Awasthiutk564/Campus-Drop/report-figures/fig-0-cover-hardware-photo.jpg

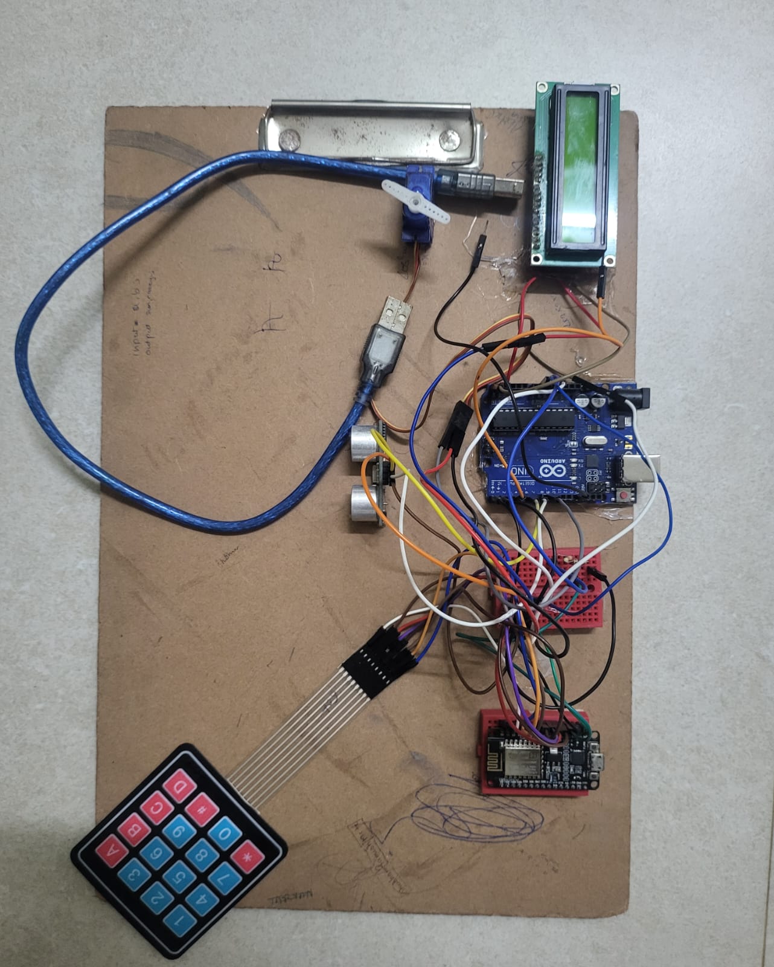
report-figures/fig-0-cover-hardware-photo.jpg
