Awasthiutk564/Campus-Drop/report-figures/fig-5-2-circuit-diagram.png

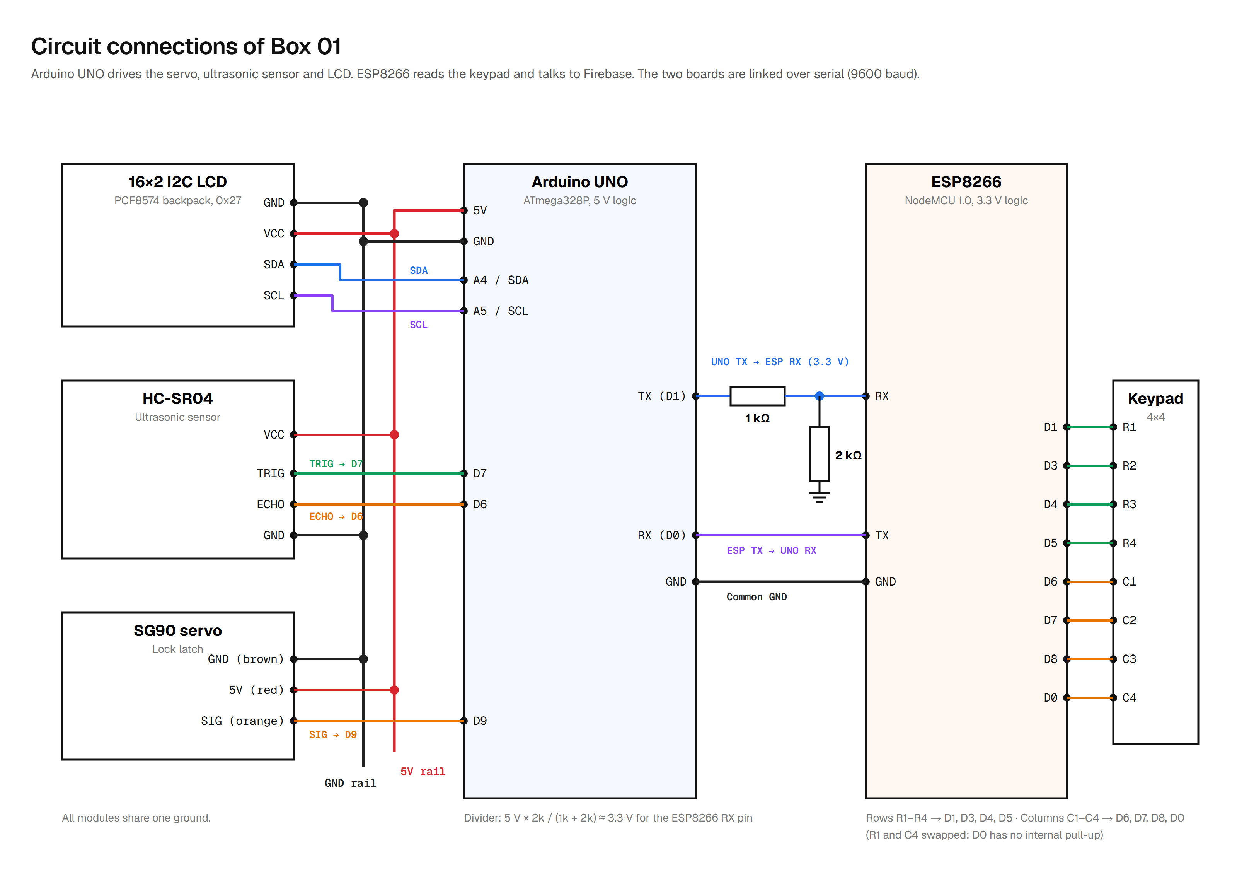
report-figures/fig-5-2-circuit-diagram.png
