Awasthiutk564/Campus-Drop/report-figures/fig-5-3-internal-arrangement.png

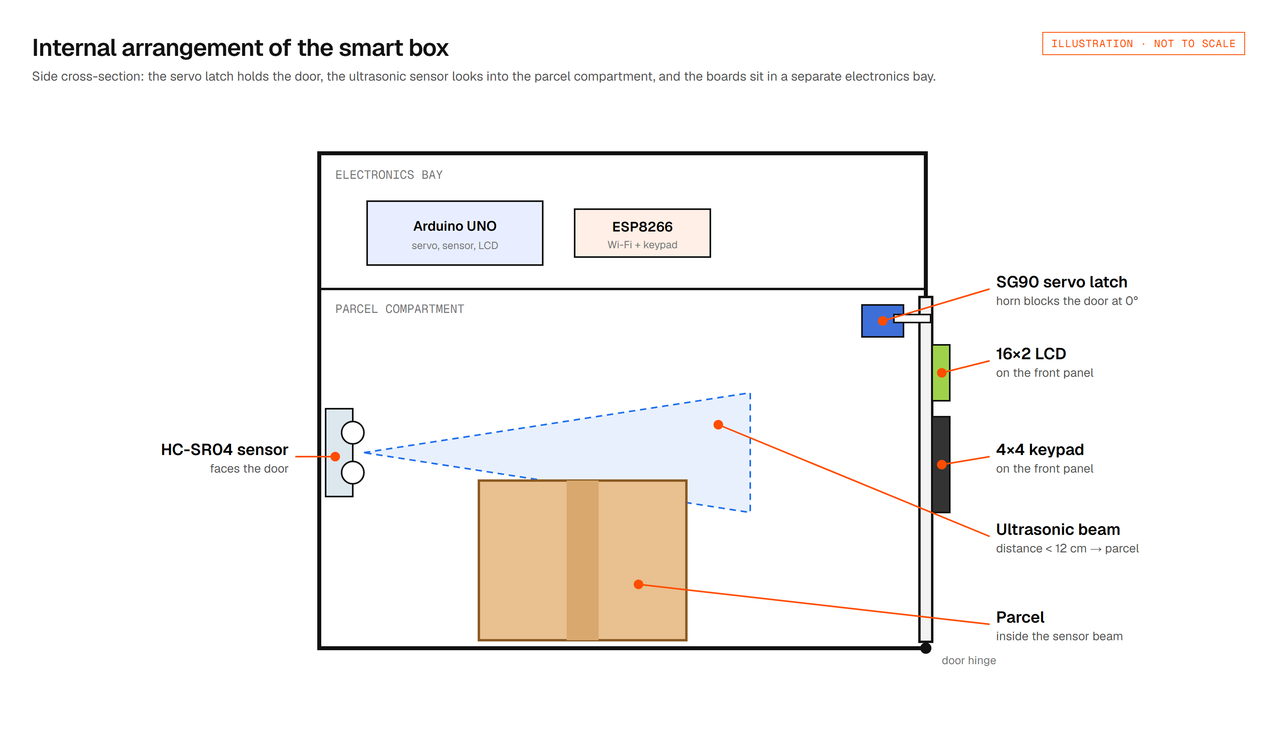
report-figures/fig-5-3-internal-arrangement.png
