Awasthiutk564/Campus-Drop/report-figures/fig-5-4-front-panel.png

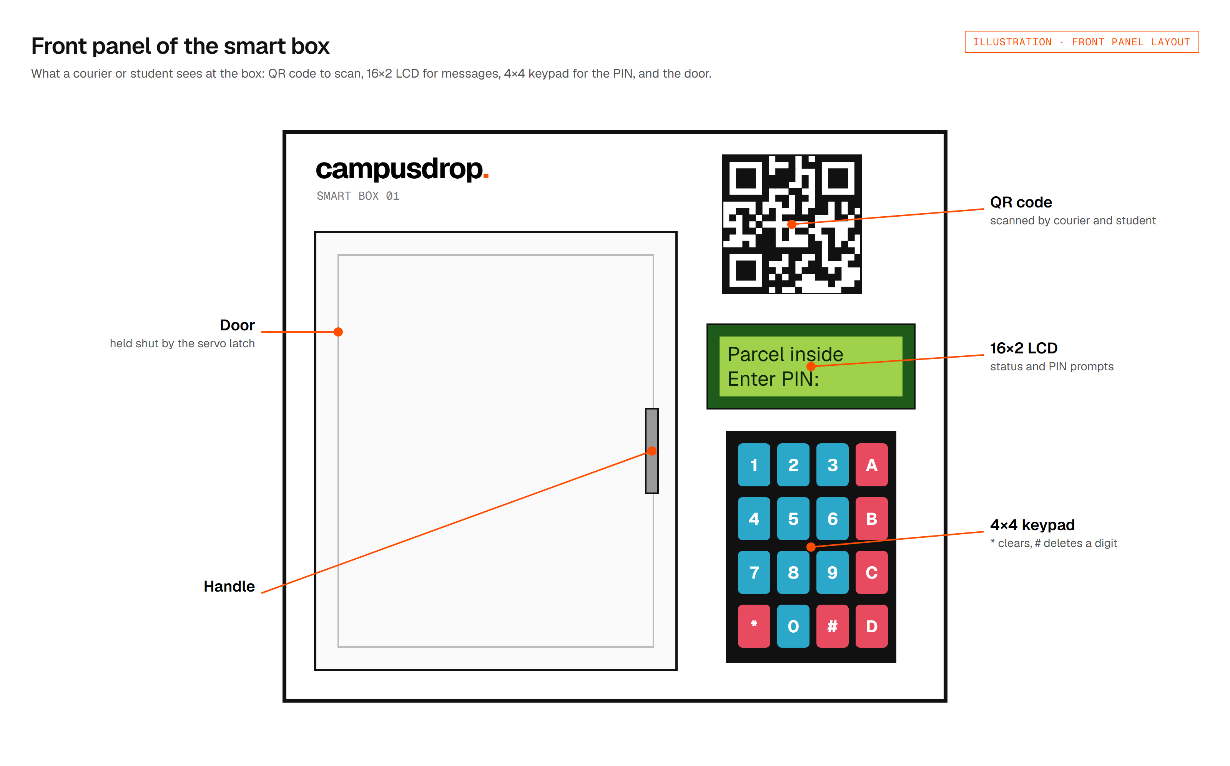
report-figures/fig-5-4-front-panel.png
