Awasthiutk564/Campus-Drop/report-figures/fig-6-0-dashboard-hero.png

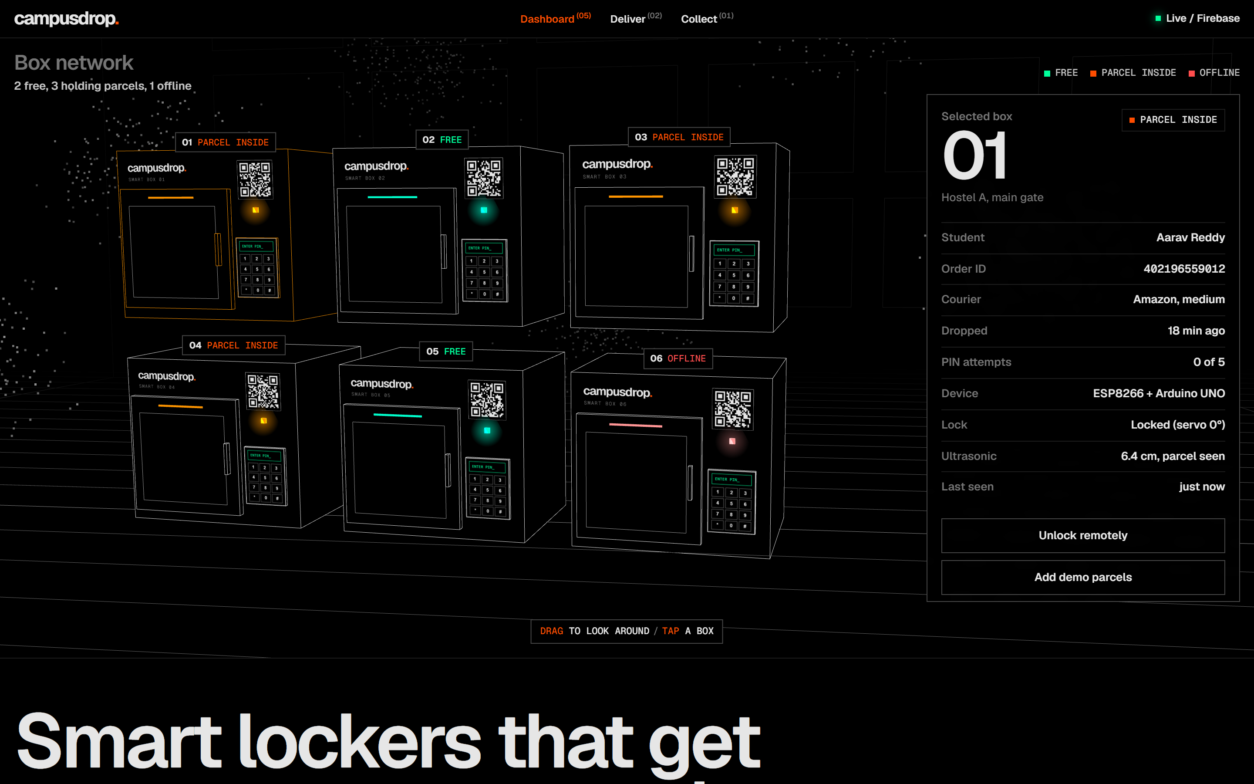
report-figures/fig-6-0-dashboard-hero.png
