Awasthiutk564/Campus-Drop/report-figures/fig-6-1-dashboard.png

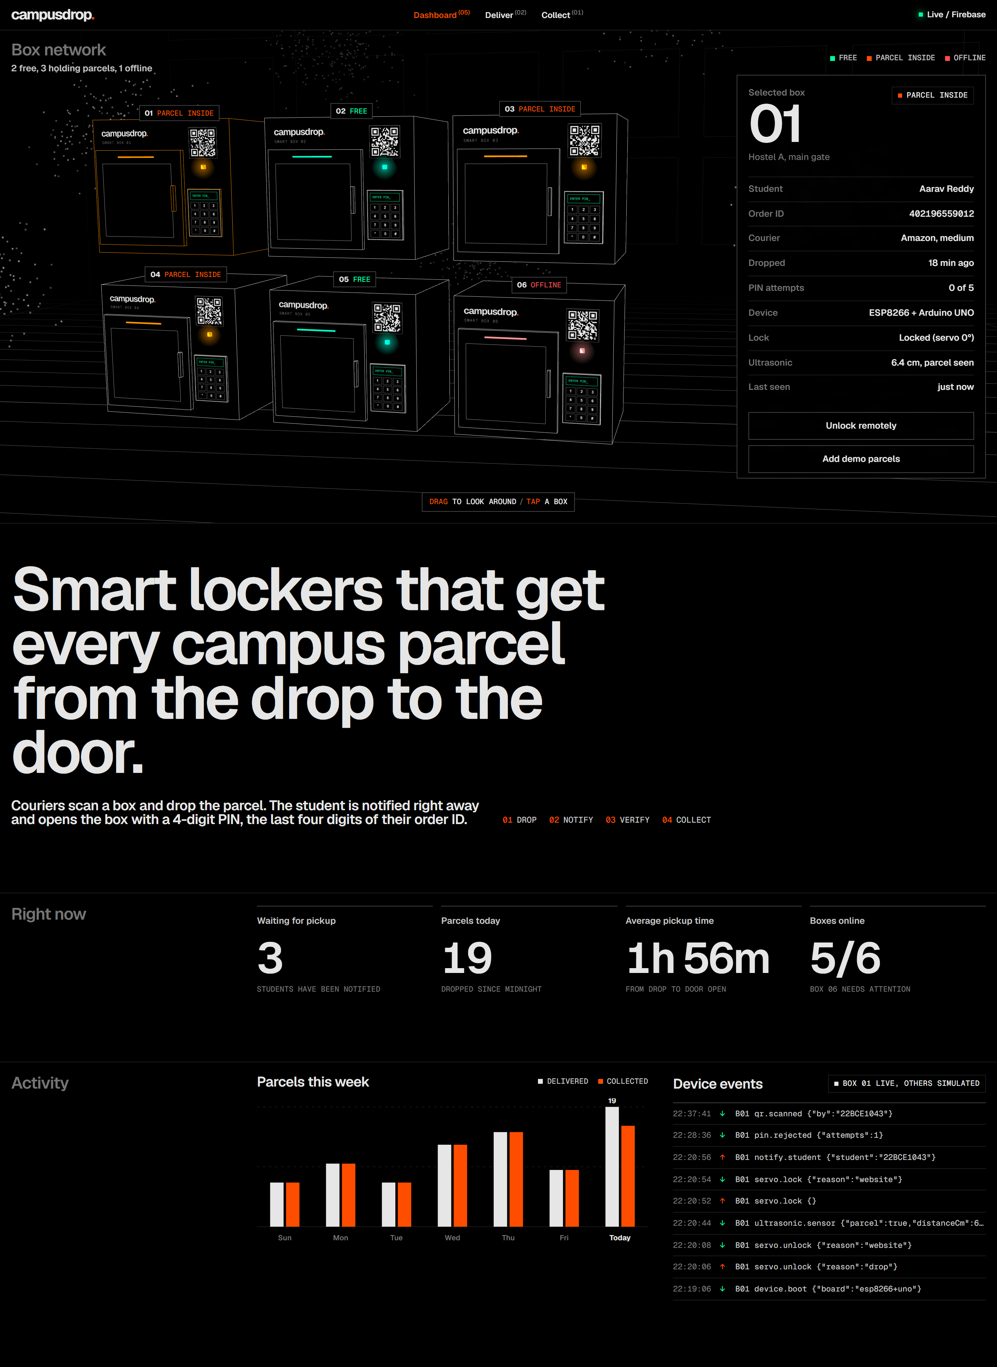
report-figures/fig-6-1-dashboard.png
