Awasthiutk564/Campus-Drop/report-figures/fig-6-3-delivery-portal.png

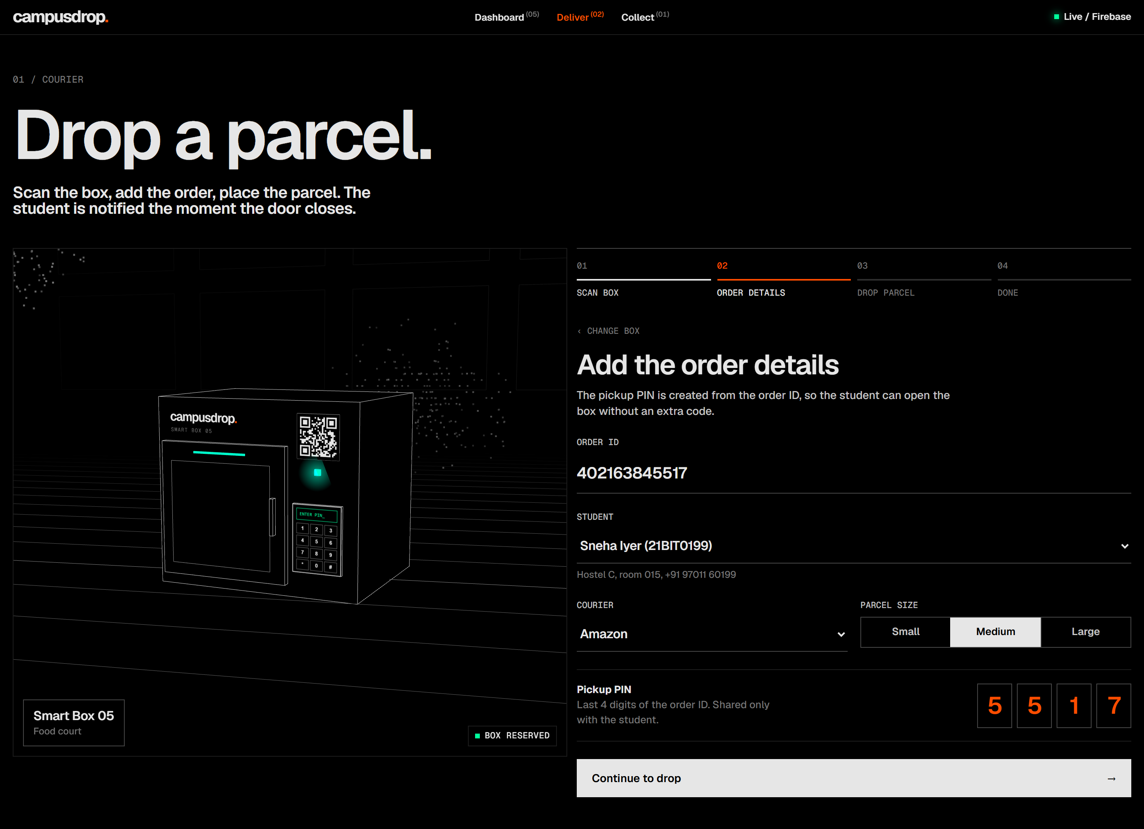
report-figures/fig-6-3-delivery-portal.png
