Awasthiutk564/Campus-Drop/report-figures/fig-6-5-notification.png

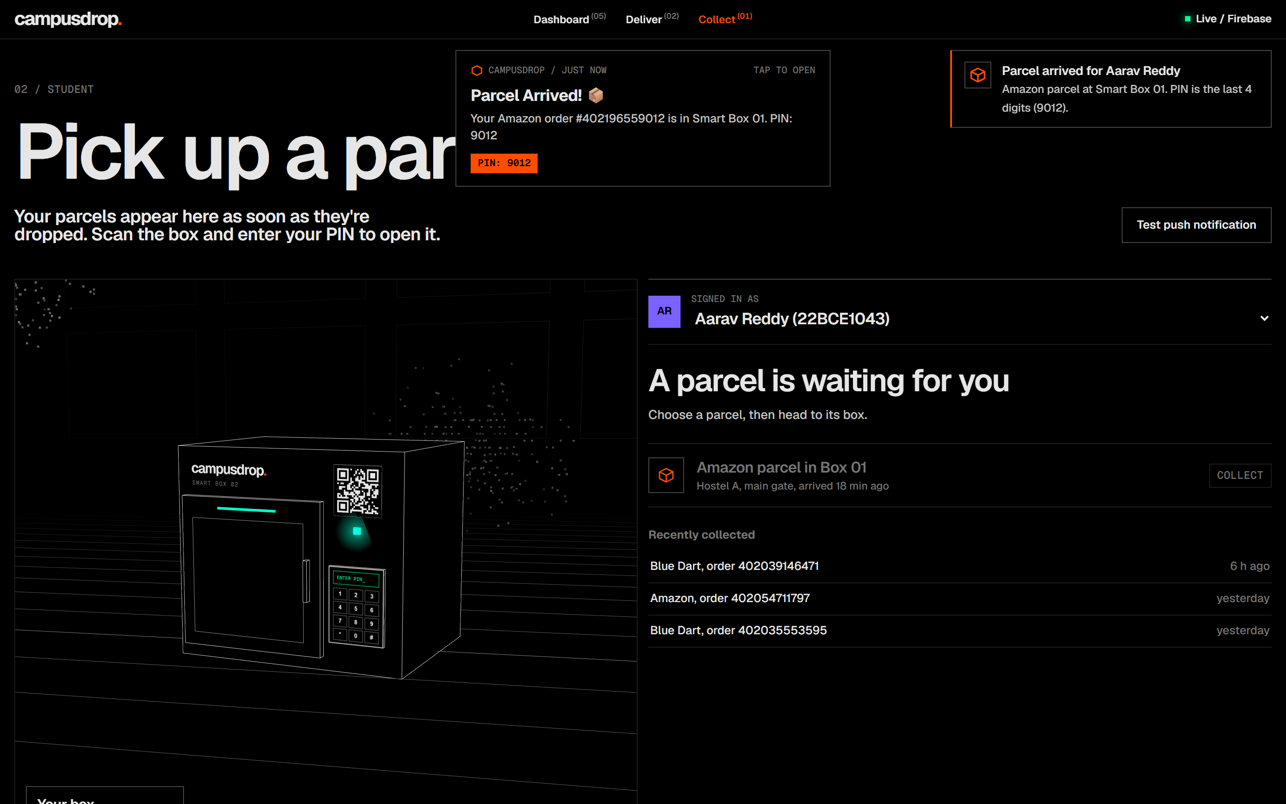
report-figures/fig-6-5-notification.png
