Awasthiutk564/Campus-Drop/report-figures/fig-6-6-pickup-pin-entry.png

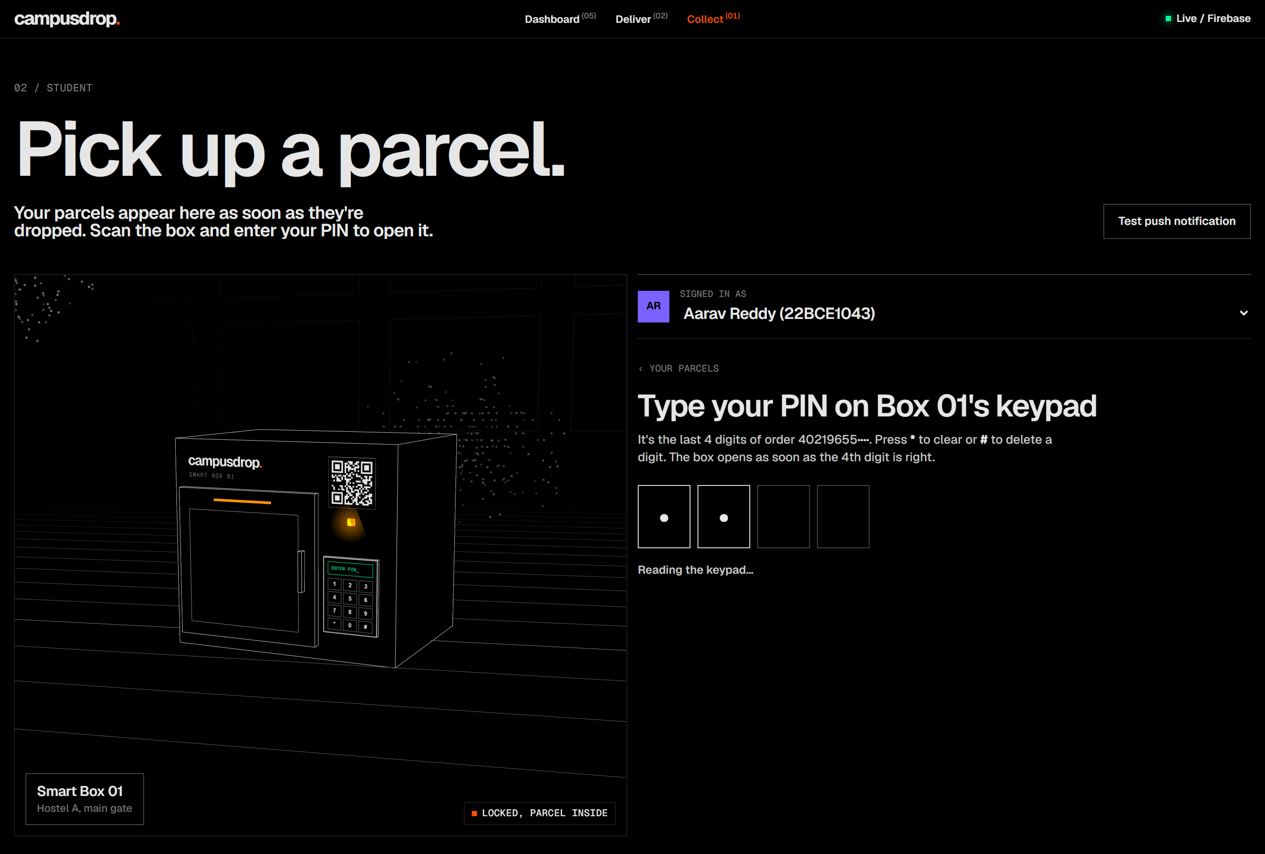
report-figures/fig-6-6-pickup-pin-entry.png
