Awasthiutk564/Campus-Drop/report-figures/fig-6-7-pickup-success.png

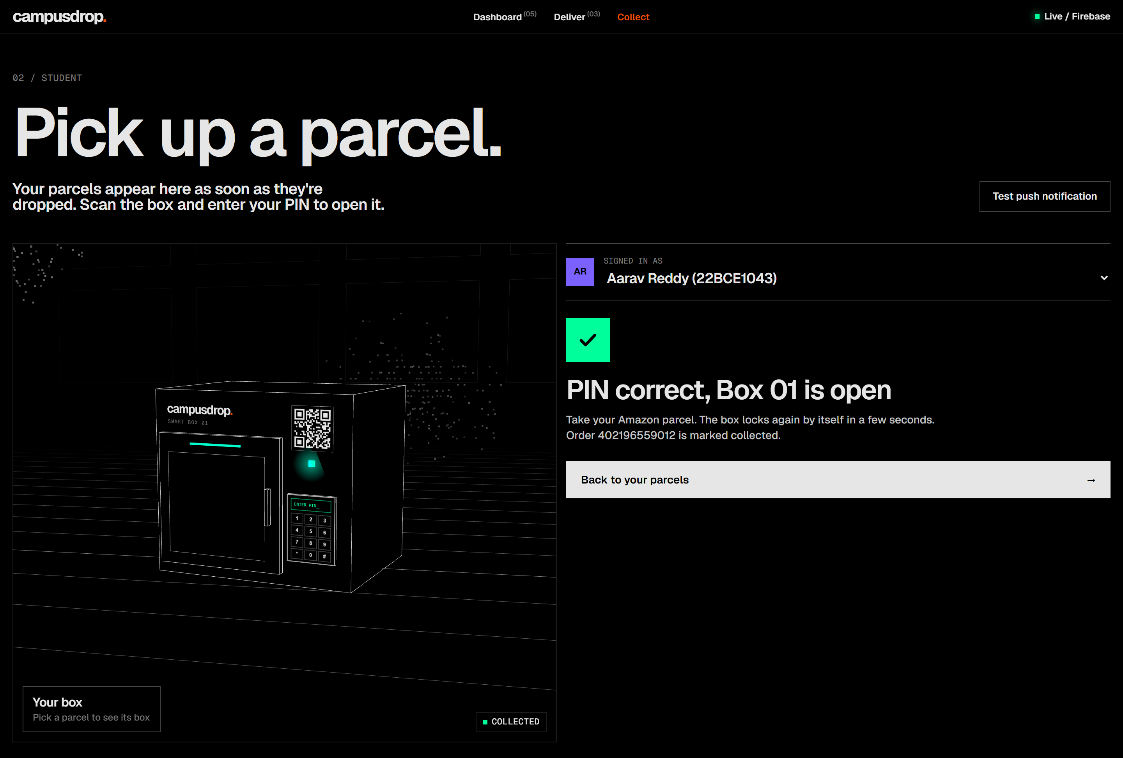
report-figures/fig-6-7-pickup-success.png
