Awasthiutk564/Campus-Drop/report-figures/fig-6-8-servo-positions.png

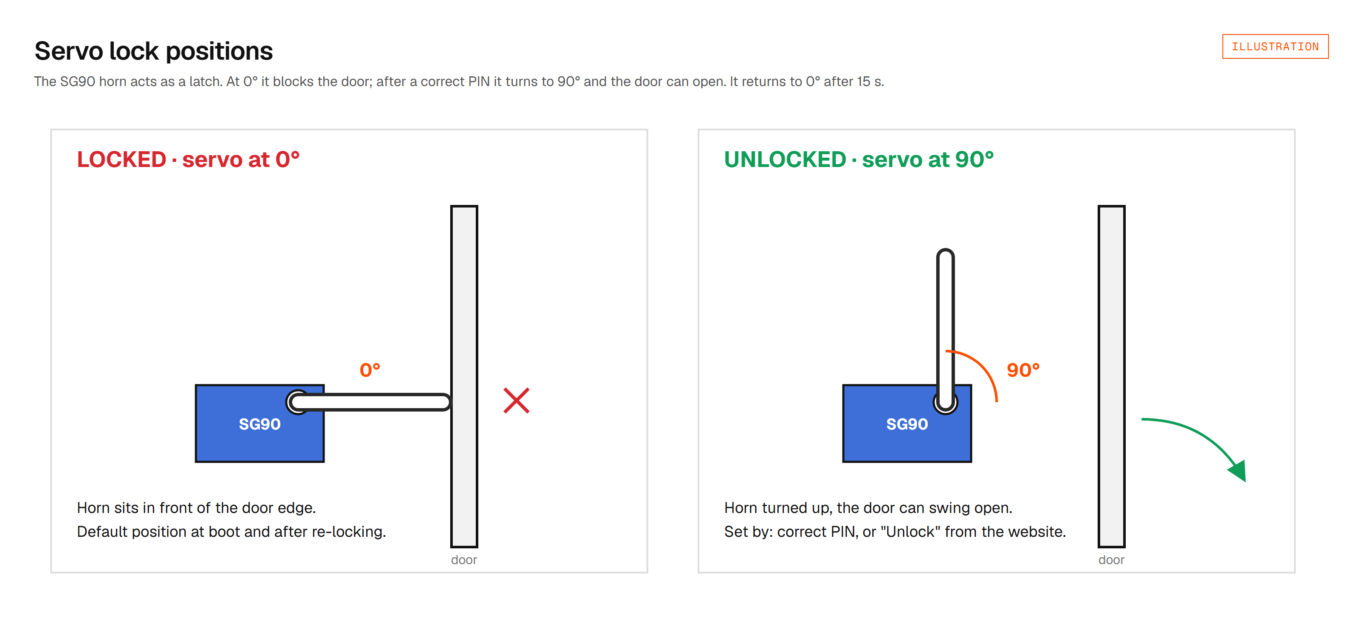
report-figures/fig-6-8-servo-positions.png
