Awasthiutk564/Campus-Drop/report-figures/fig-6-9-lcd-messages.png

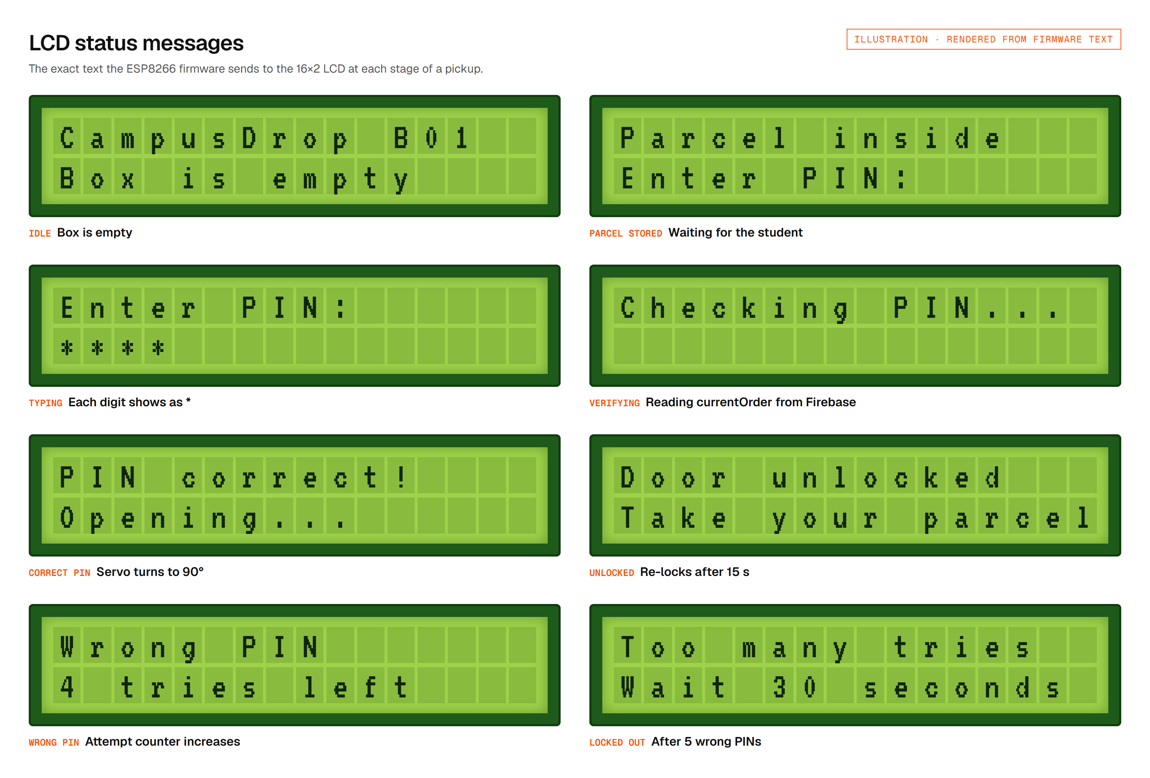
report-figures/fig-6-9-lcd-messages.png
