Awasthiutk564/Campus-Drop/report-figures/fig-6-10-parcel-detection.png

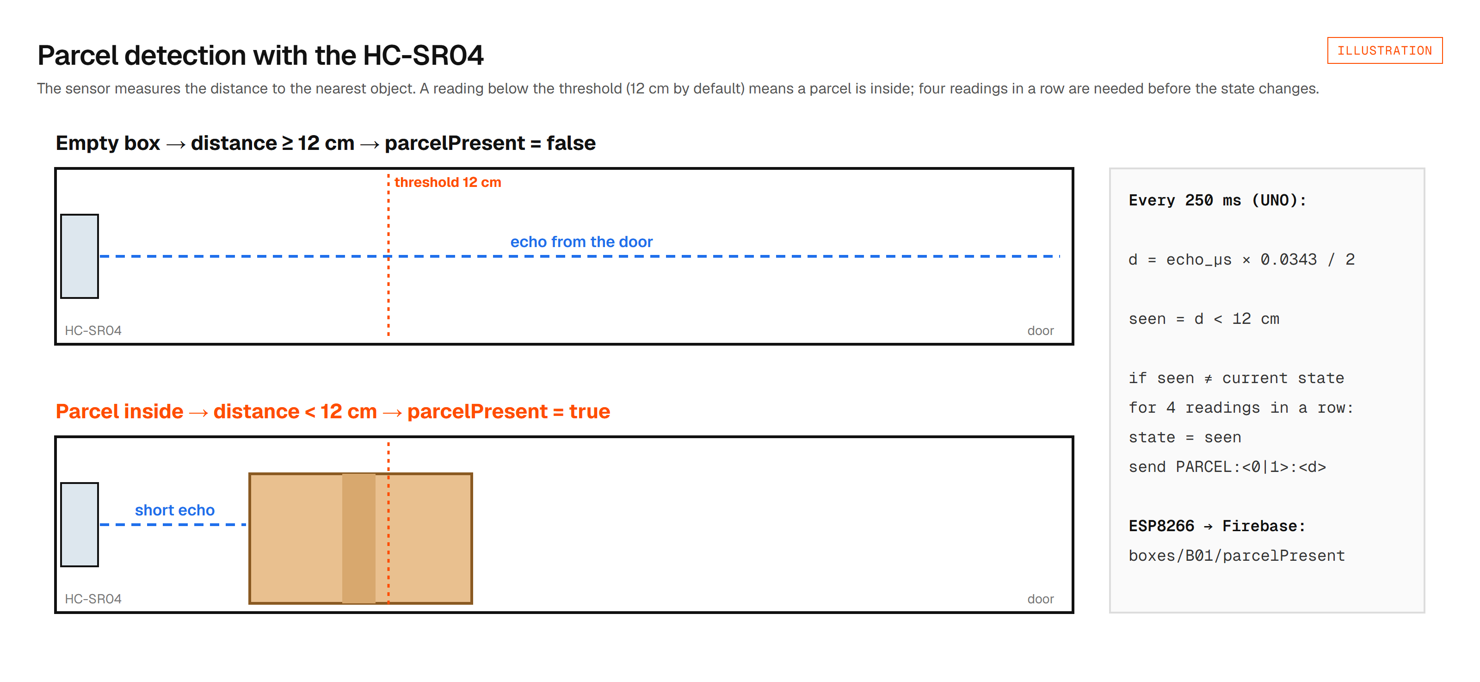
report-figures/fig-6-10-parcel-detection.png
