Awasthiutk564/Campus-Drop/report-figures/fig-6-11-database-structure.png

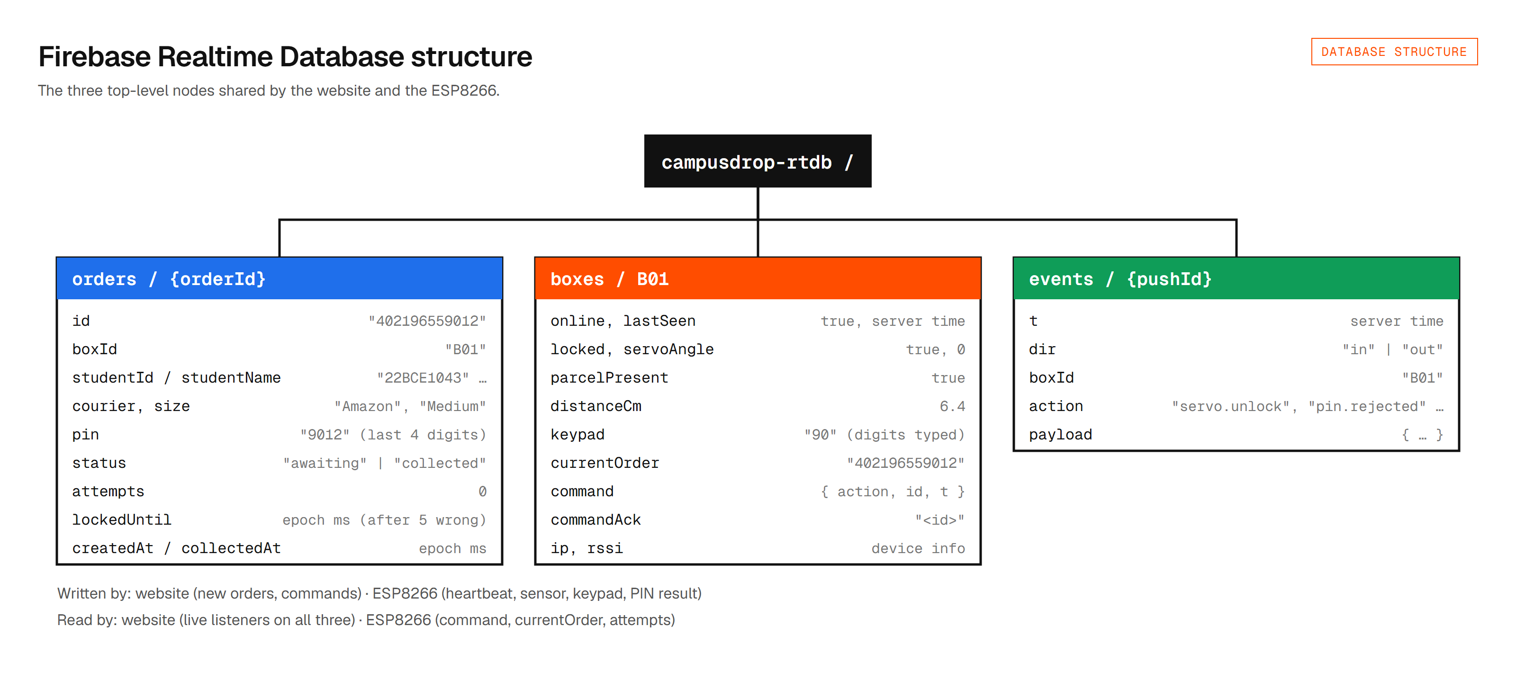
report-figures/fig-6-11-database-structure.png
