Awasthiutk564/Campus-Drop/report-figures/team-table.png

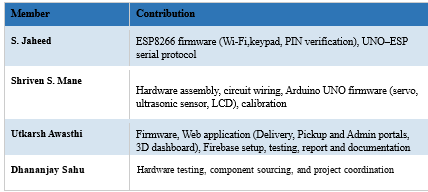
report-figures/team-table.png
