Awasthiutk564/Campus-Drop/report-figures/fig-5-1-components-labelled.jpg

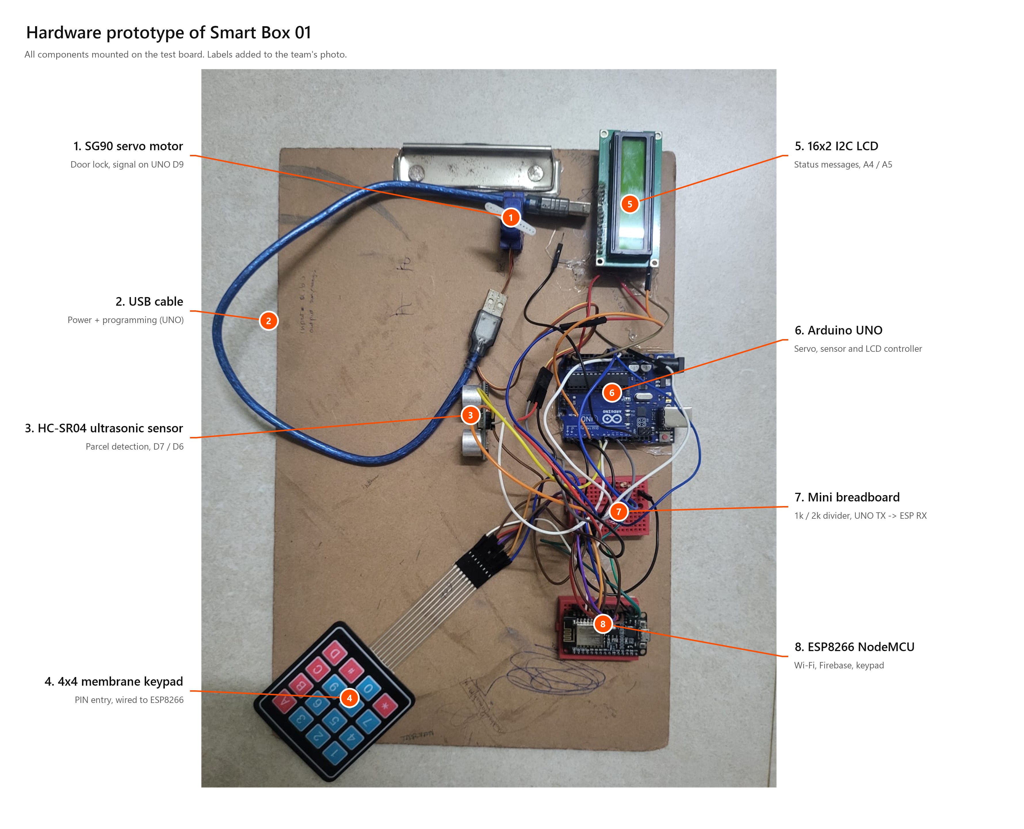
report-figures/fig-5-1-components-labelled.jpg
