Awasthiutk564/Campus-Drop/report-figures/fig-6-2-orders-and-device-events.png

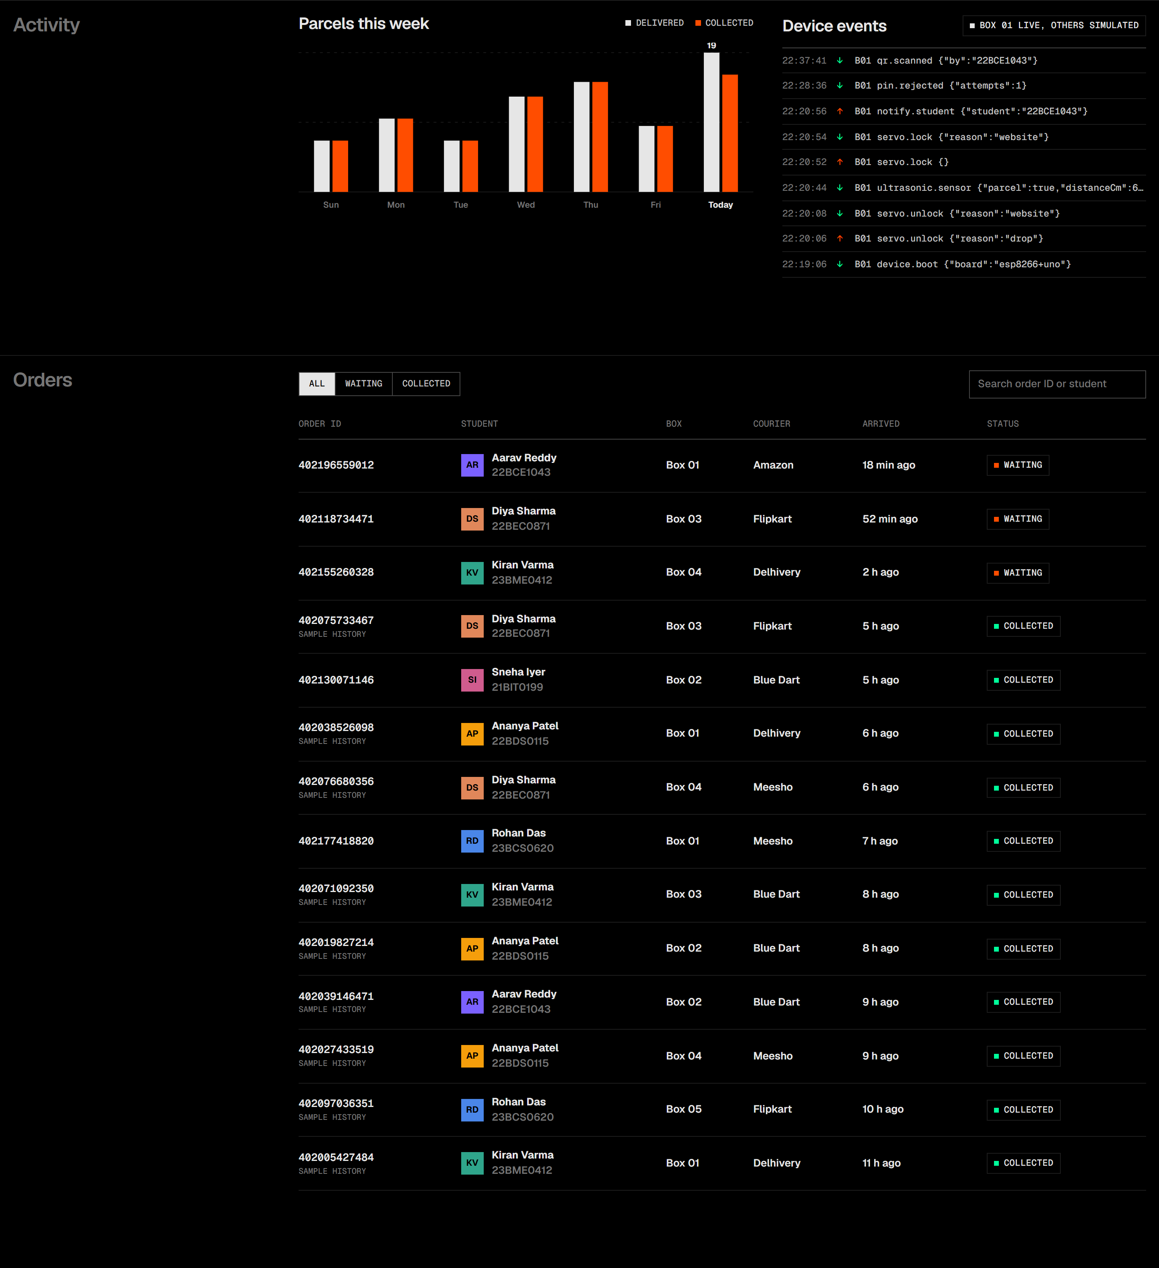
report-figures/fig-6-2-orders-and-device-events.png
