Awasthiutk564/Campus-Drop/report-figures/fig-6-4-drop-steps.png

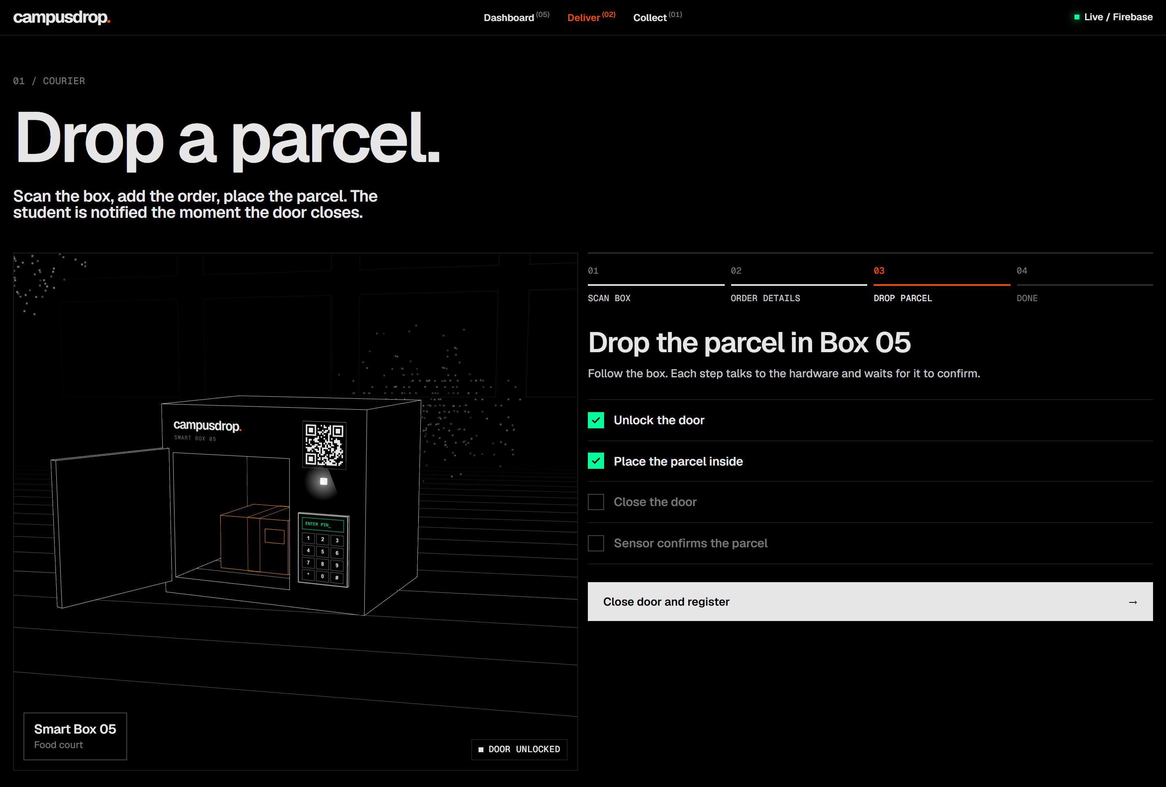
report-figures/fig-6-4-drop-steps.png
