Awasthiutk564/Campus-Drop/firmware/esp8266_campusdrop/secrets.example.h

// Copy this file to secrets.h (same folder) and fill in your own WiFi login.
// secrets.h is ignored by git, so your password never reaches GitHub.
const char *WIFI_SSID = "your-wifi-name";   // 2.4 GHz network
const char *WIFI_PASSWORD = "your-wifi-password";
