Awasthiutk564/Campus-Drop/(commit log)

2026-09-23 Updated workflow image in Readme.md for better understanding of the whole project prototype by the developers
2026-09-30 Shifted from the Node server to Firebase console database and updated the firmware codes into it for Arduino Uno + ESP32
2026-11-10 Add WiFi setup portal and OTA updates to ESP8266 firmware
    The WiFi login is no longer stored in the sketch. The box remembers its
    last network and, when it cannot join one (or has been offline for 3
    minutes), opens a "CampusDrop-Setup" network with a WiFiManager page for
    choosing the WiFi from a phone. ArduinoOTA allows later ESP8266 updates
    over WiFi after the first USB upload.
    secrets.h now holds SETUP_AP_PASSWORD and OTA_PASSWORD (still git-ignored;
    secrets.example.h is the template). README and the hardware guide describe
    the new setup and update flow.
2026-11-11 Add ultrasonic distance section and door-open pop-up
    The dashboard gets a Sensor section with a card per box showing the
    ultrasonic distance, a status and a bar marking the 12 cm parcel limit.
    Whenever a door opens (courier unlock, PIN pickup, remote unlock, or Box 01
    unlocked from its keypad) a pop-up shows the distance.
    Distances are hard-coded demo values (24.0 cm empty, 6.5 cm with a parcel)
    in one SENSOR constant; set useLive to show Box 01's real reading instead.
2026-11-11 Report UNO link diagnostics from the ESP8266
    The ESP8266 now also listens for the UNO on D2 (software serial) as well as
    the RX pin, and writes unoRxHw, unoRxSw, unoLines and unoTail to
    boxes/B01 with each heartbeat. This shows from Firebase whether anything
    from the UNO reaches the ESP8266 and on which pin. Troubleshooting row added
    to the hardware guide.
